yunochi/fpga-sigma-delta-dac/pcb/sigma-delta-dac-pcb/sigma-delta-dac-pcb.kicad_pcb

## KiCad design pcb/sigma-delta-dac-pcb/sigma-delta-dac-pcb.kicad_pcb (2026-08-06)

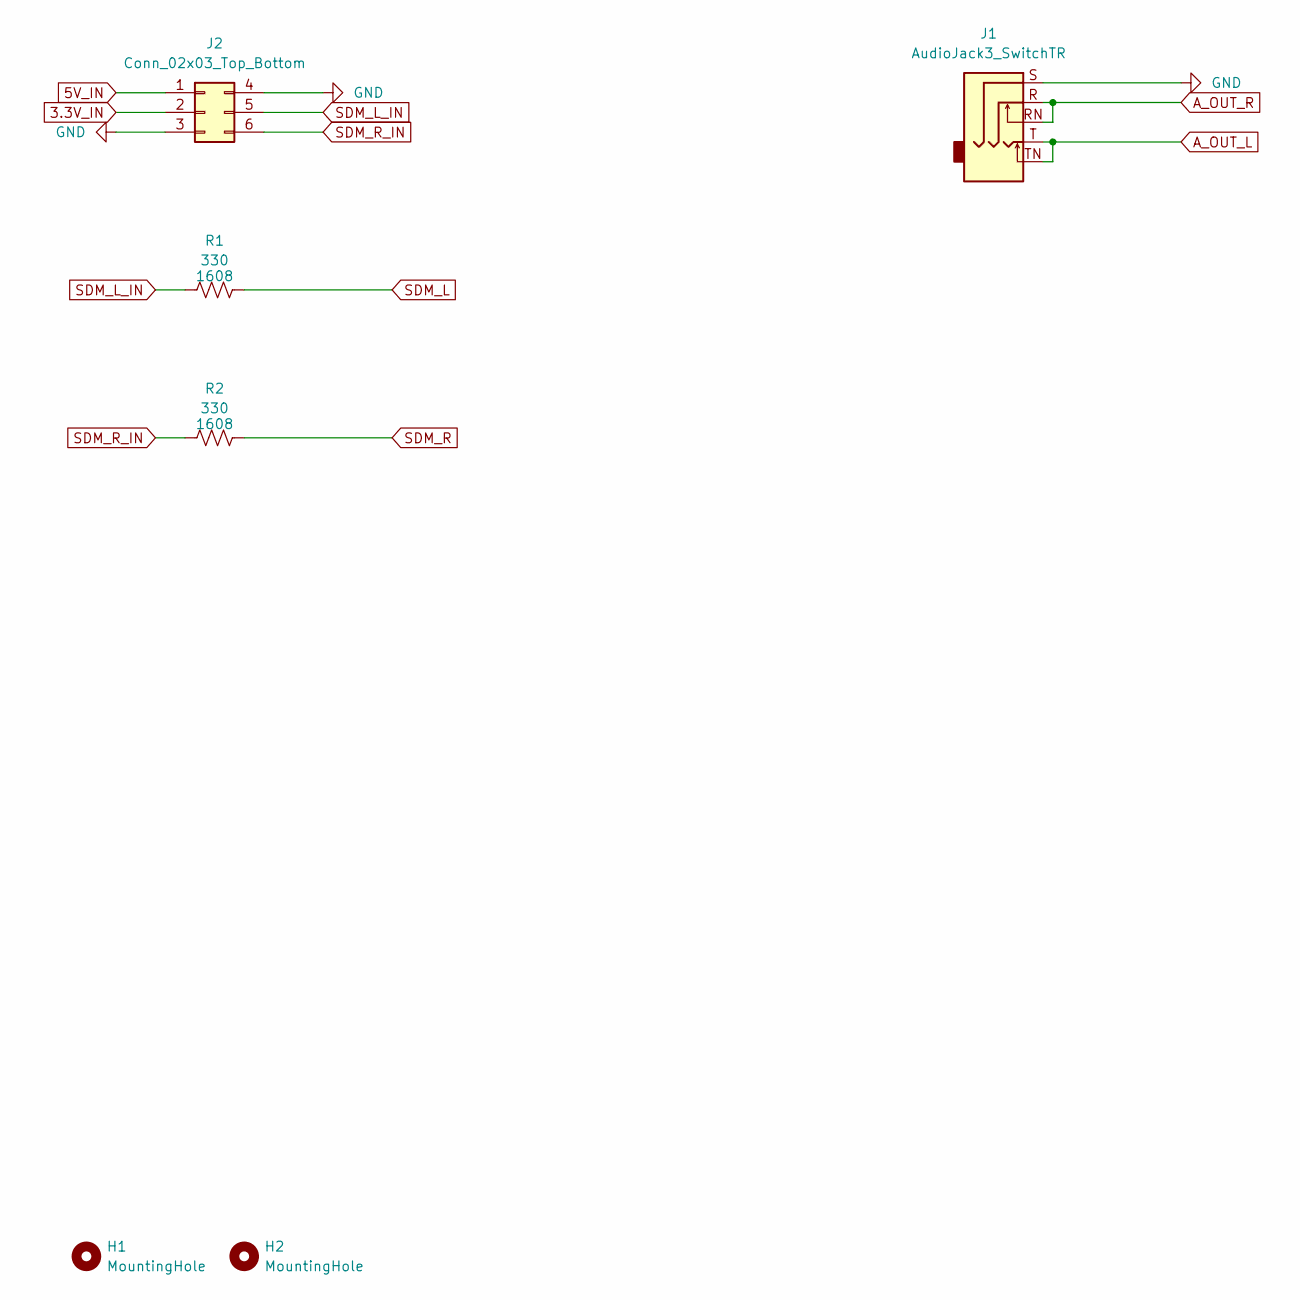
[picture p1: schematic conn.kicad_sch]

Parts:
H1, H2: MountingHole; MountingHole_3.2mm_M3
J1: AudioJack3_SwitchTR; Jack_3.5mm_CUI_SJ1-3525N_Horizontal
J2: Conn_02x03_Top_Bottom; PinSocket_2x03_P2.54mm_Vertical
R1, R2: 330; R_0603_1608Metric

Connections:
3.3V_IN: J2.2
5V_IN: J2.1; also elsewhere on the board
A_OUT_L: J1.T, J1.TN; also elsewhere on the board
A_OUT_R: J1.R, J1.RN; also elsewhere on the board
GND: J1.S, J2.3, J2.4; also elsewhere on the board
SDM_L: R1.2; also elsewhere on the board
SDM_L_IN: J2.5, R1.1
SDM_R: R2.2; also elsewhere on the board
SDM_R_IN: J2.6, R2.1

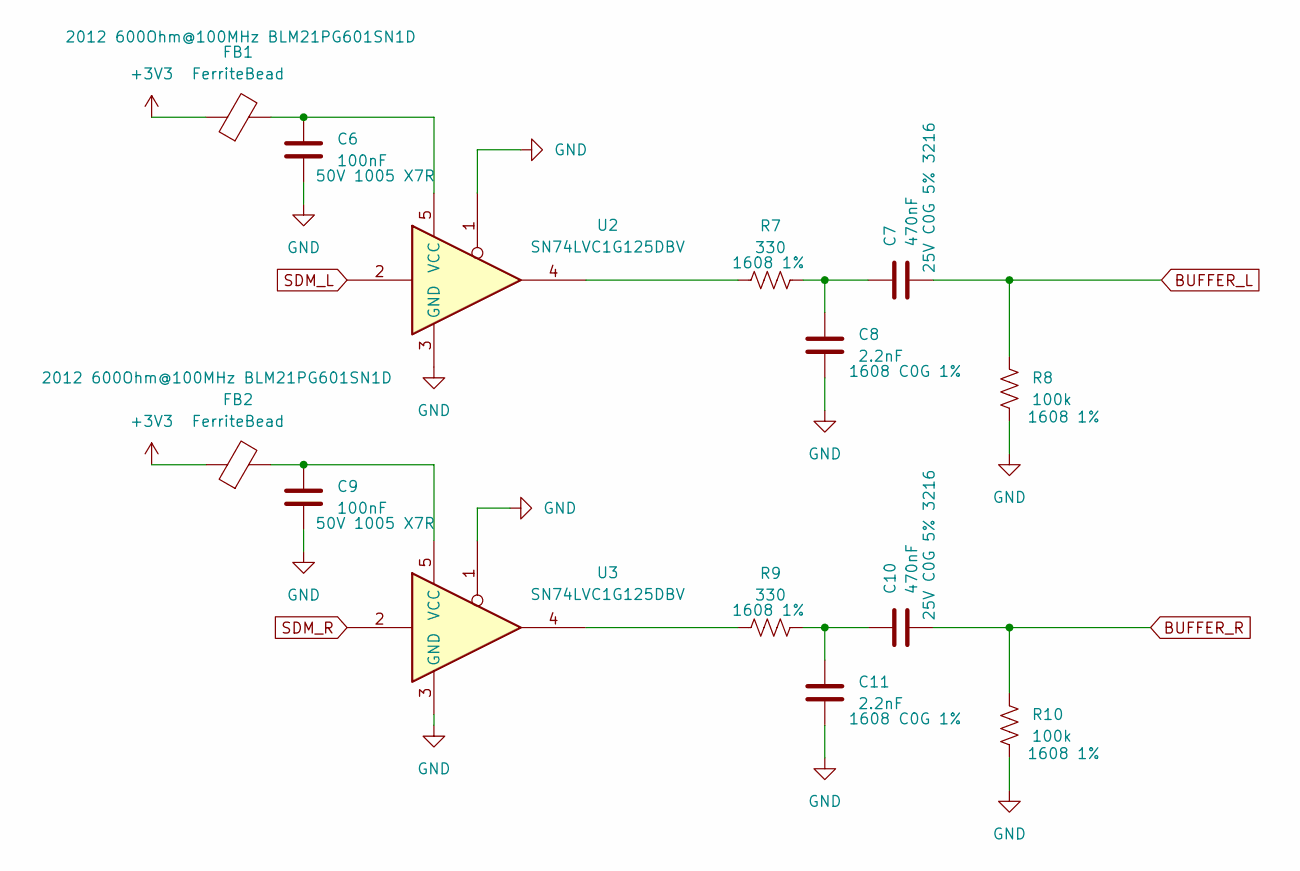
[picture p2: schematic buffer.kicad_sch]

Parts:
C6, C9: 100nF; C_0402_1005Metric
C7, C10: 470nF; C_1206_3216Metric
C8, C11: 2.2nF; C_0603_1608Metric
FB1, FB2: FerriteBead; L_0805_2012Metric
R7, R9: 330; R_0603_1608Metric
R8, R10: 100k; R_0603_1608Metric
U2, U3: SN74LVC1G125DBV; SOT-23-5

Connections:
+3V3: FB1.1, FB2.1; also elsewhere on the board
BUFFER_L: C7.2, R8.1; also elsewhere on the board
BUFFER_R: C10.2, R10.1; also elsewhere on the board
GND: C6.2, C8.2, C9.2, C11.2, R8.2, R10.2, U2.1, U2.3 (GND), U3.1, U3.3 (GND); also elsewhere on the board
unnamed: C7.1, C8.1, R7.2
unnamed: C10.1, C11.1, R9.2
unnamed: R7.1, U2.4
unnamed: R9.1, U3.4
unnamed: C6.1, FB1.2, U2.5 (VCC)
unnamed: C9.1, FB2.2, U3.5 (VCC)
SDM_L: U2.2; also elsewhere on the board
SDM_R: U3.2; also elsewhere on the board

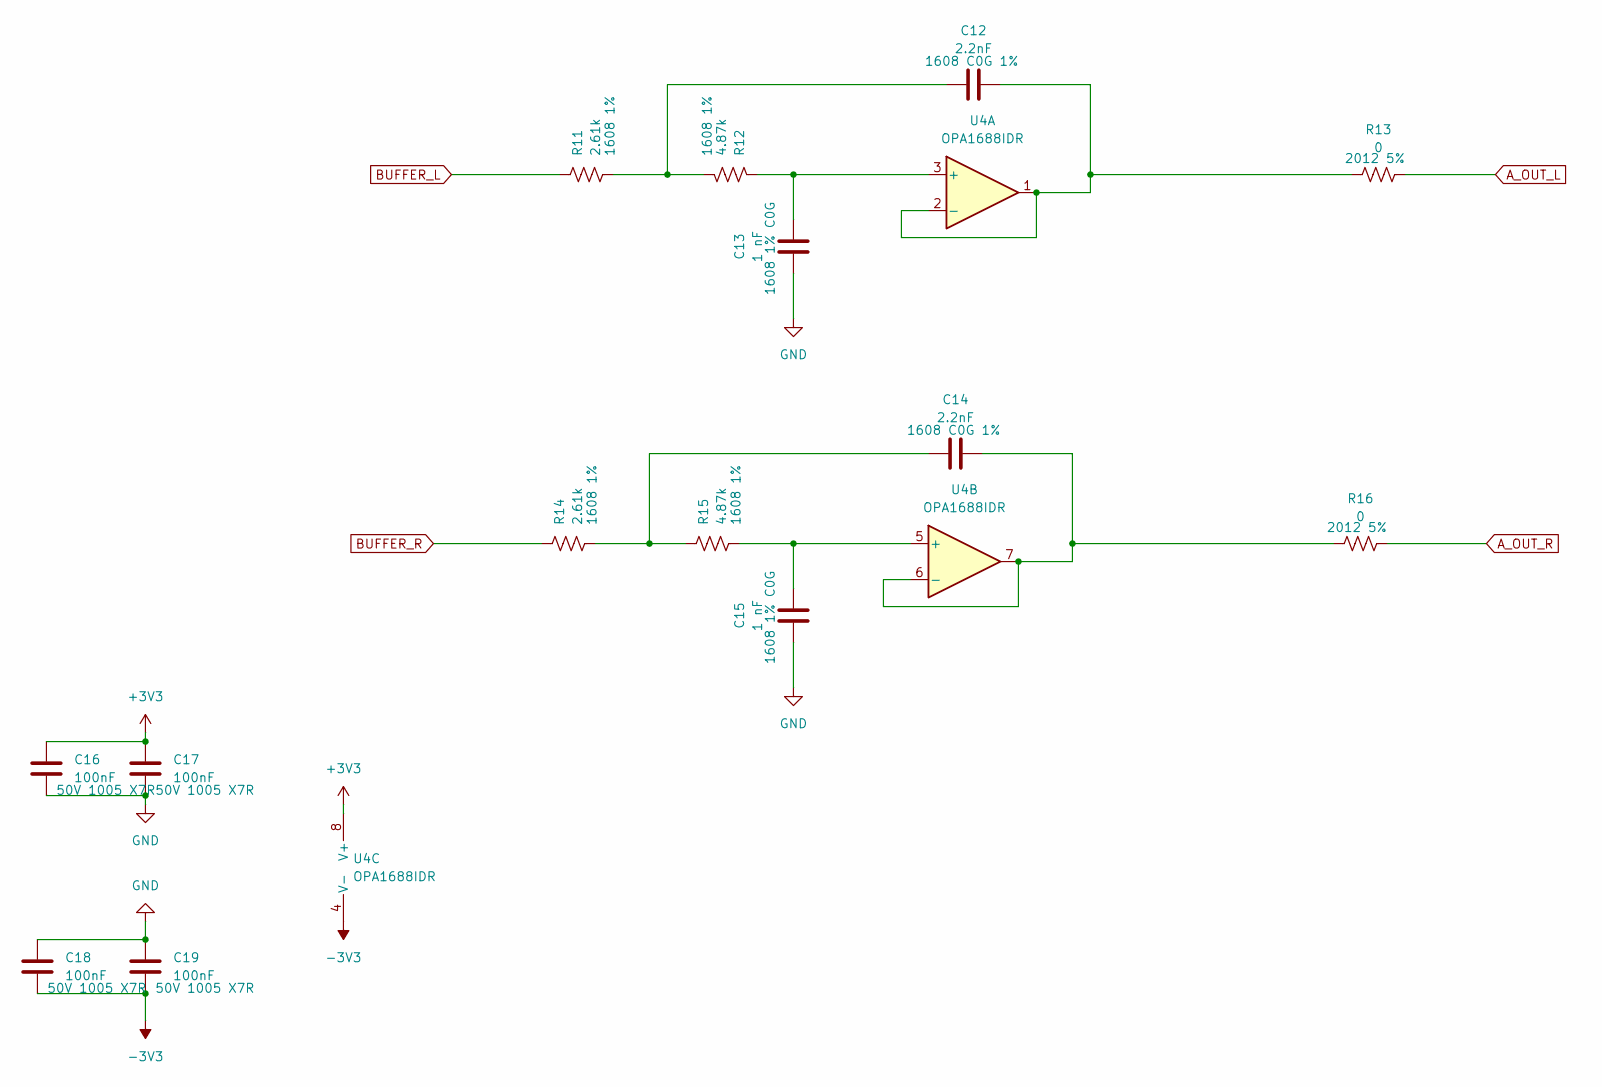
[picture p3: schematic filter.kicad_sch]

Parts:
C12, C14: 2.2nF; C_0603_1608Metric
C13, C15: 1 nF; C_0603_1608Metric
C16, C17, C18, C19: 100nF; C_0402_1005Metric
R11, R14: 2.61k; R_0603_1608Metric
R12, R15: 4.87k; R_0603_1608Metric
R13, R16: 0; R_0805_2012Metric
U4: OPA1688IDR; SOIC-8_3.9x4.9mm_P1.27mm

Connections:
+3V3: C16.1, C17.1, U4.8 (V+); also elsewhere on the board
-3V3: C18.2, C19.2, U4.4 (V-); also elsewhere on the board
A_OUT_L: R13.2; also elsewhere on the board
A_OUT_R: R16.2; also elsewhere on the board
BUFFER_L: R11.1; also elsewhere on the board
BUFFER_R: R14.1; also elsewhere on the board
GND: C13.1, C15.1, C16.2, C17.2, C18.1, C19.1; also elsewhere on the board
unnamed: C12.1, R11.2, R12.2
unnamed: C14.1, R14.2, R15.1
unnamed: C13.2, R12.1, U4.3 (+)
unnamed: C12.2, R13.1, U4.1, U4.2 (-)
unnamed: C15.2, R15.2, U4.5 (+)
unnamed: C14.2, R16.1, U4.6 (-), U4.7

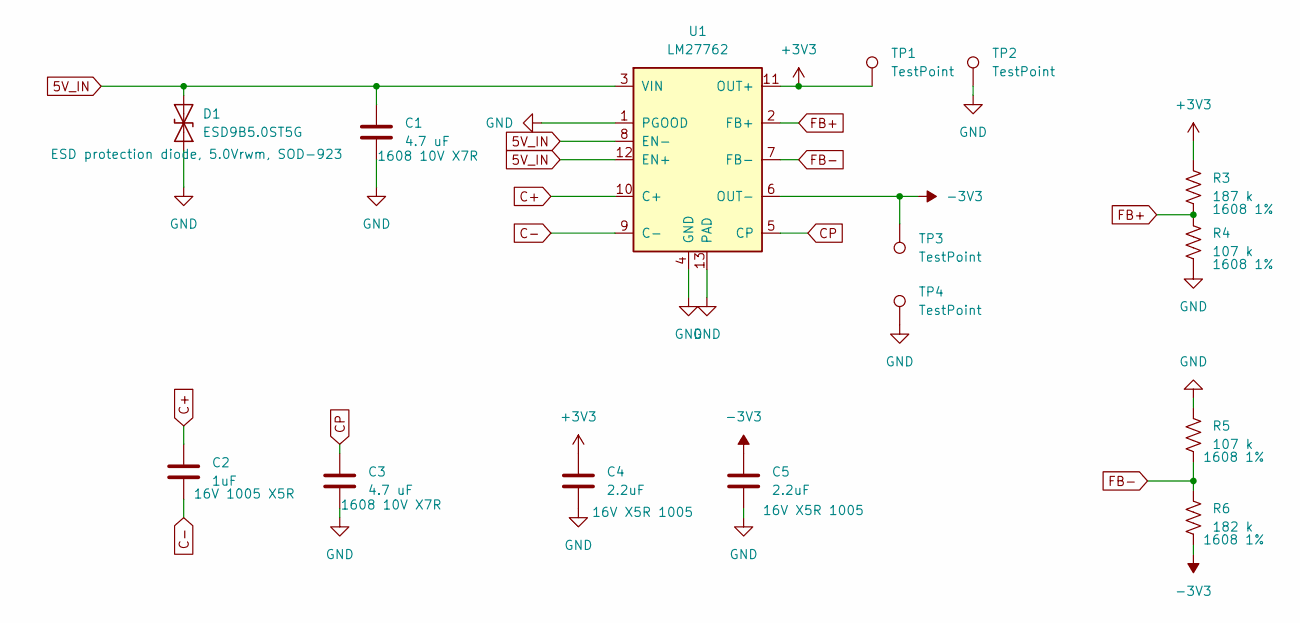
[picture p4: schematic power.kicad_sch]

Parts:
C1, C3: 4.7 uF; C_0603_1608Metric
C2: 1uF; C_0402_1005Metric
C4, C5: 2.2uF; C_0402_1005Metric
D1: ESD9B5.0ST5G; D_SOD-923
R3: 187 k; R_0603_1608Metric
R4, R5: 107 k; R_0603_1608Metric
R6: 182 k; R_0603_1608Metric
TP1, TP2, TP3, TP4: TestPoint; TestPoint_Pad_1.0x1.0mm
U1: LM27762; WSON-12-1EP_3x2mm_P0.5mm_EP1x2.65_ThermalVias

Connections:
5V_IN: C1.1, D1.2 (A2), U1.3 (VIN), U1.8 (EN-), U1.12 (EN+); also elsewhere on the board
+3V3: C4.1, R3.1, TP1.1 (1_1), U1.11 (OUT+); also elsewhere on the board
-3V3: C5.1, R6.2, TP3.1 (1_1), U1.6 (OUT-); also elsewhere on the board
C+: C2.1, U1.10 (C+)
C-: C2.2, U1.9 (C-)
CP: C3.1, U1.5 (CP)
FB+: R3.2, R4.1, U1.2 (FB+)
FB-: R5.2, R6.1, U1.7 (FB-)
GND: C1.2, C3.2, C4.2, C5.2, D1.1 (A1), R4.2, R5.1, TP2.1 (1_1), TP4.1 (1_1), U1.1 (PGOOD), U1.4 (GND), U1.13 (PAD); also elsewhere on the board

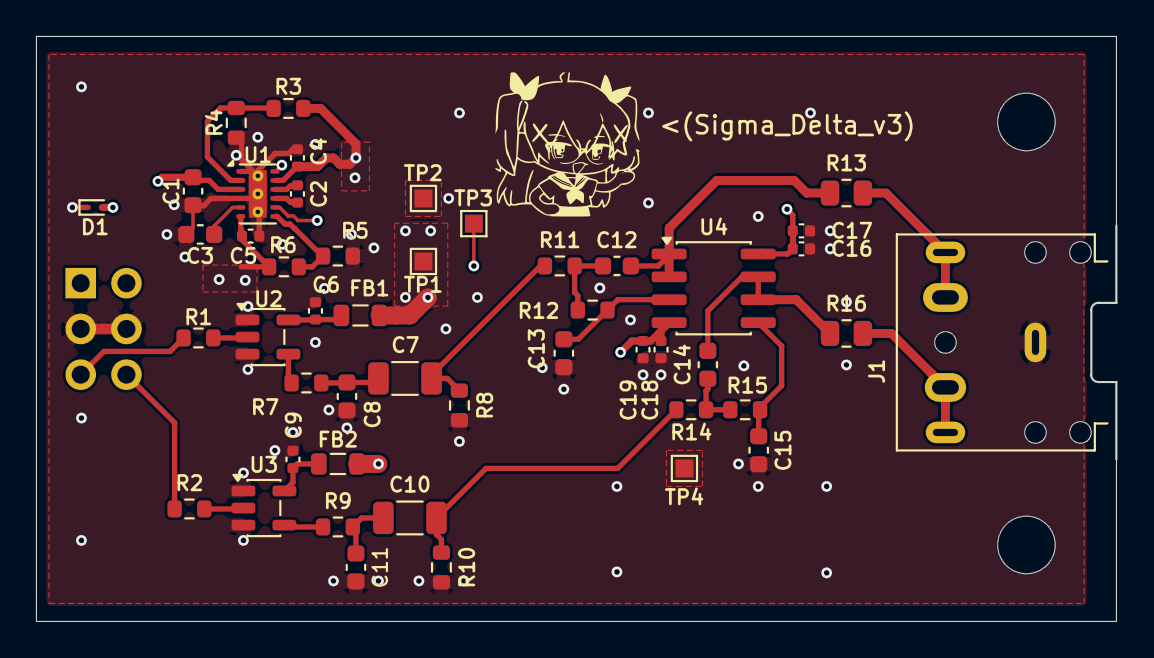
[picture p5: board sigma-delta-dac-pcb.kicad_pcb from above]

Board: 4 copper layers, 60.0 x 32.5 mm, 50 parts (1 on the bottom side), 29 nets.
