yunochi/fpga-sigma-delta-dac/fpga/xilinx/src/xdc/puzhi/new/puzhi.xdc

set_property PACKAGE_PIN W10 [get_ports pdm_out_l]
set_property PACKAGE_PIN AA11 [get_ports pdm_out_r]

set_property IOSTANDARD LVCMOS33 [get_ports pdm_out_*]
set_property DRIVE 16 [get_ports pdm_out_*]
set_property SLEW SLOW [get_ports pdm_out_*]
set_max_delay 30.0 -to [get_ports pdm_out_*]
set_min_delay 0 -to [get_ports pdm_out_*]

set_property IOSTANDARD LVCMOS33 [get_ports s_i2s_*]
set_property PACKAGE_PIN Y12 [get_ports s_i2s_sck]
set_property PACKAGE_PIN AG13 [get_ports s_i2s_ws]
set_property PACKAGE_PIN AA12 [get_ports s_i2s_sd]

set_max_delay 30.0 -from [get_ports s_i2s_sd]
set_min_delay 0 -from [get_ports s_i2s_sd]
set_max_delay 20.0 -to [get_ports s_i2s_sck]
set_min_delay 0 -to [get_ports s_i2s_sck]
set_max_delay 20.0 -to [get_ports s_i2s_ws]
set_min_delay 0 -to [get_ports s_i2s_ws]

set_property IOSTANDARD LVDS [get_ports clk_200M_*]
set_property PACKAGE_PIN L3 [get_ports clk_200M_p]
set_property PACKAGE_PIN L2 [get_ports clk_200M_n]
set_property DIFF_TERM_ADV TERM_100 [get_ports clk_200M_*]
create_clock -period 5.000 -name clk_200M [get_ports clk_200M_p]

set_property PACKAGE_PIN AH6 [get_ports data_act_led]
set_property IOSTANDARD LVCMOS18 [get_ports data_act_led]
set_false_path -to [get_ports data_act_led]

set_property PACKAGE_PIN D2 [get_ports sys_rstn_i]
set_property IOSTANDARD LVCMOS18 [get_ports sys_rstn_i]
set_false_path -from [get_ports sys_rstn_i]

set_property BITSTREAM.GENERAL.COMPRESS TRUE [current_design]
