yunochi/fpga-sigma-delta-dac/fpga/xilinx/src/hdl/top.v

`timescale 1ns / 1ps


module top(
        output pdm_out_l,
        output pdm_out_r,
        input clk_200M_p,
        input clk_200M_n,
        output s_i2s_sck,
        output s_i2s_ws,
        input s_i2s_sd,
        input wire sys_rstn_i,
        output wire data_act_led
    );
    wire diff_buf_out;
    IBUFDS IBUFDS_inst (
               .O(diff_buf_out),
               .I(clk_200M_p),
               .IB(clk_200M_n)
           );
    wire clk_200M;
    BUFG BUFG_inst (
             .O(clk_200M), // 1-bit output: Clock output.
             .I(diff_buf_out)  // 1-bit input: Clock input.
         );

    wire sys_clk; //24.576MHz Clock
    parameter OVERSAMPLE_RATIO = 256;

    wire reset_n;
    wire [31:0]axis_tdata;
    wire axis_tlast;
    reg axis_tready;
    wire axis_tvalid;

    design_1_wrapper design_1_wrapper_inst (
                         .clk_200M(clk_200M),
                         .sys_clk(sys_clk),
                         .sys_rstn_i(sys_rstn_i),
                         .reset_n(reset_n)
                     );
    i2s_rx i2s_rx_inst(
               .clk(sys_clk),
               .rst_n(reset_n),
               .sck(s_i2s_sck),
               .ws(s_i2s_ws),
               .sd(s_i2s_sd),
               .tready(axis_tready),
               .tdata(axis_tdata),
               .data_valid(axis_tvalid),
               .data_act_led(data_act_led),
               .fifo_empty(),
               .fifo_full(),
               .fifo_data_count()
           );
    wire signed [15:0] pdm_val_l;
    wire signed [15:0] pdm_val_r;
    wire signed [15:0] fir_out_l_2x;
    wire signed [15:0] fir_out_l_4x;
    wire signed [15:0] fir_out_r_2x;
    wire signed [15:0] fir_out_r_4x;

    reg [15:0] sample_wait_cnt;
    reg [15:0] pcm_in_l;
    reg [15:0] pcm_in_r;

    always @(posedge sys_clk) begin
        if (!reset_n) begin
            axis_tready <= 0;
            sample_wait_cnt <= 0;
            pcm_in_l <= 0; pcm_in_r <= 0;
        end
        else begin
            if (axis_tvalid && axis_tready) begin
                axis_tready <= 0;
                sample_wait_cnt <= 0;
                pcm_in_l <= axis_tdata[15:0];
                pcm_in_r <= axis_tdata[31:16];
            end
            else begin
                // 카운터가 끝에 도달할 때까지 증가 (데이터가 안 오면 OVERSAMPLE_RATIO-1 에서 유지)
                if (sample_wait_cnt < OVERSAMPLE_RATIO-1) begin
                    sample_wait_cnt <= sample_wait_cnt + 1;
                end
                if (sample_wait_cnt == OVERSAMPLE_RATIO-2) begin
                    // 다음 클럭에 새 데이터 캡쳐하기 위해 미리 tready 를 1로 설정
                    axis_tready <= 1;
                end
            end
        end
    end

    fir_upsampler_2x #(
                         .DATA_WIDTH(16),
                         .OVERSAMPLING_RATIO(OVERSAMPLE_RATIO)
                     ) fir_l_2x (
                         .clk(sys_clk),
                         .rst_n(reset_n),
                         .data_in(pcm_in_l),
                         .interval_cnt(sample_wait_cnt),
                         .data_out(fir_out_l_2x)
                     );
    fir_upsampler_2x #(
                         .DATA_WIDTH(16),
                         .OVERSAMPLING_RATIO(OVERSAMPLE_RATIO / 2)
                     ) fir_l_4x (
                         .clk(sys_clk),
                         .rst_n(reset_n),
                         .data_in(fir_out_l_2x),
                         .interval_cnt(sample_wait_cnt),
                         .data_out(fir_out_l_4x)
                     );
    linear_interpolation #(
                             .DATA_WIDTH(16),
                             .OVERSAMPLING_RATIO(OVERSAMPLE_RATIO / 4)
                         ) interpolation_l (
                             .clk(sys_clk),
                             .rst_n(reset_n),
                             .data_in(fir_out_l_4x),
                             .interval_cnt(sample_wait_cnt),
                             .data_out(pdm_val_l)
                         );

    fir_upsampler_2x #(
                         .DATA_WIDTH(16),
                         .OVERSAMPLING_RATIO(OVERSAMPLE_RATIO)
                     ) fir_r_2x (
                         .clk(sys_clk),
                         .rst_n(reset_n),
                         .data_in(pcm_in_r),
                         .interval_cnt(sample_wait_cnt),
                         .data_out(fir_out_r_2x)
                     );
    fir_upsampler_2x #(
                         .DATA_WIDTH(16),
                         .OVERSAMPLING_RATIO(OVERSAMPLE_RATIO / 2)
                     ) fir_r_4x (
                         .clk(sys_clk),
                         .rst_n(reset_n),
                         .data_in(fir_out_r_2x),
                         .interval_cnt(sample_wait_cnt),
                         .data_out(fir_out_r_4x)
                     );
    linear_interpolation #(
                             .DATA_WIDTH(16),
                             .OVERSAMPLING_RATIO(OVERSAMPLE_RATIO / 4)
                         ) interpolation_r (
                             .clk(sys_clk),
                             .rst_n(reset_n),
                             .data_in(fir_out_r_4x),
                             .interval_cnt(sample_wait_cnt),
                             .data_out(pdm_val_r)
                         );

    sigma_delta_3rd_order sg_inst_l (
                              .clk(sys_clk),
                              .rst_n(reset_n),
                              .din(pdm_val_l),
                              .dout(pdm_out_l)
                          );
    sigma_delta_3rd_order sg_inst_r (
                              .clk(sys_clk),
                              .rst_n(reset_n),
                              .din(pdm_val_r),
                              .dout(pdm_out_r)
                          );

endmodule
