yunochi/fpga-sigma-delta-dac/fpga/common/rtl/fir_upsample.v

module fir_upsampler_2x #(
        parameter integer DATA_WIDTH = 16,
        parameter integer OVERSAMPLING_RATIO = 256
    ) (
        input wire clk,
        input wire rst_n,
        input wire signed [DATA_WIDTH-1:0] data_in,
        input wire [15:0] interval_cnt,
        output reg signed [DATA_WIDTH-1:0] data_out
    );

    wire [15:0] interval_cnt_mod = interval_cnt & (OVERSAMPLING_RATIO - 1);
    // =========================================================================
    // Filter Architecture & Storage
    // =========================================================================
    // 127-tap symmetric Half-Band FIR filter.
    // Since it's a Half-Band filter, every even tap is zero.
    // Thus, we store 64 input samples to compute the symmetric even samples.
    reg signed [DATA_WIDTH-1:0] x_reg [0:63];

    // Shift register for input samples.
    // Triggered at the beginning of a new input sample period (interval_cnt_mod == 0).
    integer i;
    always @(posedge clk or negedge rst_n) begin
        if (!rst_n) begin
            for (i = 0; i < 64; i = i + 1) begin
                x_reg[i] <= {DATA_WIDTH{1'b0}};
            end
        end else if (interval_cnt_mod == 16'd0) begin
            x_reg[0] <= data_in;
            for (i = 1; i < 64; i = i + 1) begin
                x_reg[i] <= x_reg[i-1];
            end
        end
    end

    // 32 non-zero coefficients for the symmetric taps (left/right half).
    // Q15 fixed-point representation.
    function signed [15:0] get_coef(input [4:0] idx);
        begin
            case (idx)
                // Verilog get_coef(idx) values, idx=0 (outermost) -> idx=63 (innermost):
                5'd0:  get_coef = -16'sd26;
                5'd1:  get_coef = 16'sd28;
                5'd2:  get_coef = -16'sd32;
                5'd3:  get_coef = 16'sd36;
                5'd4:  get_coef = -16'sd44;
                5'd5:  get_coef = 16'sd54;
                5'd6:  get_coef = -16'sd66;
                5'd7:  get_coef = 16'sd80;
                5'd8:  get_coef = -16'sd98;
                5'd9:  get_coef = 16'sd118;
                5'd10:  get_coef = -16'sd140;
                5'd11:  get_coef = 16'sd168;
                5'd12:  get_coef = -16'sd200;
                5'd13:  get_coef = 16'sd234;
                5'd14:  get_coef = -16'sd274;
                5'd15:  get_coef = 16'sd320;
                5'd16:  get_coef = -16'sd372;
                5'd17:  get_coef = 16'sd430;
                5'd18:  get_coef = -16'sd496;
                5'd19:  get_coef = 16'sd574;
                5'd20:  get_coef = -16'sd662;
                5'd21:  get_coef = 16'sd766;
                5'd22:  get_coef = -16'sd888;
                5'd23:  get_coef = 16'sd1036;
                5'd24:  get_coef = -16'sd1220;
                5'd25:  get_coef = 16'sd1456;
                5'd26:  get_coef = -16'sd1770;
                5'd27:  get_coef = 16'sd2215;
                5'd28:  get_coef = -16'sd2899;
                5'd29:  get_coef = 16'sd4115;
                5'd30:  get_coef = -16'sd6922;
                5'd31:  get_coef = 16'sd20863;
                default: get_coef = 16'sd0;
            endcase
        end
    endfunction

    // =========================================================================
    // Pipelined Serial MAC (Multiply-Accumulate) Control & Datapath
    // =========================================================================
    // The MAC unit computes the even sample using symmetric pre-addition.
    //
    // Pipeline Timeline:
    // Cycle t   (interval_cnt_mod 0 ~ 31)  : Pre-adder & Coefficient fetch
    // Cycle t+1 (interval_cnt_mod 1 ~ 32)  : Multiplication
    // Cycle t+2 (interval_cnt_mod 2 ~ 33)  : Accumulation (init on cycle 2)
    // Cycle t+3 (interval_cnt_mod 34)      : Saturation and Registering even output

    // Pipeline Stage Enables
    wire preadd_en  = (interval_cnt_mod < 32);
    wire mul_en     = (interval_cnt_mod >= 1 && interval_cnt_mod <= 32);
    wire accum_init = (interval_cnt_mod == 2);
    wire accum_en   = (interval_cnt_mod >= 3 && interval_cnt_mod <= 33);
    wire out_en     = (interval_cnt_mod == 34);

    // Datapath Registers
    reg signed [DATA_WIDTH:0]    pre_add;  // Pre-adder output (17 bits for 16-bit input)
    reg signed [15:0]            coef_reg; // Coefficient register
    reg signed [DATA_WIDTH+16:0] mul_val;  // Multiplier output (33 bits)
    reg signed [DATA_WIDTH+21:0] accum;    // Accumulator (adds 32 products, needs +5 bits headroom)
    reg signed [DATA_WIDTH-1:0]  even_out; // Registered even output sample

    // Cycle t: Pre-adder & Coefficient fetch (1-cycle latency)
    // Pre-adds symmetric input samples: x[idx] + x[63 - idx]
    always @(posedge clk  or negedge rst_n) begin
        if (!rst_n) begin
            pre_add  <= {(DATA_WIDTH+1){1'b0}};
            coef_reg <= 16'sd0;
        end else if (preadd_en) begin
            pre_add  <= $signed(x_reg[interval_cnt_mod[4:0]]) + $signed(x_reg[63 - interval_cnt_mod[4:0]]);
            coef_reg <= get_coef(interval_cnt_mod[4:0]);
        end
    end

    // Cycle t+1: Multiplier (1-cycle latency)
    // Computes pre_add * coef_reg
    always @(posedge clk or negedge rst_n) begin
        if (!rst_n) begin
            mul_val <= {(DATA_WIDTH+17){1'b0}};
        end else if (mul_en) begin
            mul_val <= pre_add * coef_reg;
        end
    end

    // Cycle t+2: Accumulator (1-cycle latency)
    always @(posedge clk or negedge rst_n) begin
        if (!rst_n) begin
            accum <= {(DATA_WIDTH+21){1'b0}};
        end else begin
            if (accum_init) begin
                accum <= mul_val;
            end else if (accum_en) begin
                accum <= accum + mul_val;
            end
        end
    end

    // Cycle t+3: Saturation (1-cycle latency)
    // The coefficients are in Q15 format, so we shift right by 15.
    // The accumulated sum is saturated to prevent overflow before assigning to 16-bit output.
    wire signed [23:0] sum_shifted = accum >>> 15;

    always @(posedge clk or negedge rst_n) begin
        if (!rst_n) begin
            even_out <= {DATA_WIDTH{1'b0}};
        end else if (out_en) begin
            if (sum_shifted > 32767) begin
                even_out <= 32767;
            end else if (sum_shifted < -32768) begin
                even_out <= -32768;
            end else begin
                even_out <= sum_shifted[15:0];
            end
        end
    end

    // =========================================================================
    // Center Tap Delay Pipeline
    // =========================================================================
    // For a half-band filter, the center tap is 0.5. To match the latency of the
    // even sample calculations, the center tap sample (x_reg[31])
    // must be delayed by 35 clock cycles.
    reg signed [DATA_WIDTH-1:0] odd_delay [0:34];
    integer k;

    always @(posedge clk or negedge rst_n) begin
        if (!rst_n) begin
            for (k = 0; k < 35; k = k + 1) begin
                odd_delay[k] <= {DATA_WIDTH{1'b0}};
            end
        end else begin
            odd_delay[0] <= x_reg[31];
            for (k = 1; k < 35; k = k + 1) begin
                odd_delay[k] <= odd_delay[k-1];
            end
        end
    end

    wire signed [DATA_WIDTH-1:0] odd_out = odd_delay[34];

    // =========================================================================
    // Output Multiplexer (Even/Odd Interleaving)
    // =========================================================================
    // The output transitions are synchronized, resulting in a 2x upsampled stream.
    //
    // - For the first half of the input sample period, output the even filter result.
    // - For the second half, output the delayed center-tap sample.
    always @(posedge clk or negedge rst_n) begin
        if (!rst_n) begin
            data_out <= {DATA_WIDTH{1'b0}};
        end else begin
            if (interval_cnt_mod < (OVERSAMPLING_RATIO / 2)) begin
                data_out <= even_out;
            end else begin
                data_out <= odd_out;
            end
        end
    end
endmodule
