yunochi/fpga-sigma-delta-dac/fpga/common/rtl/sigma-delta-3rd-order.v

module sigma_delta_3rd_order #(
        parameter integer WIDTH = 32
    ) (
        input wire clk,
        input wire rst_n,
        input wire signed [15:0] din,
        output reg dout
    );

    localparam signed [WIDTH-1:0] POS_FB = 32767 <<< 8;
    localparam signed [WIDTH-1:0] NEG_FB = -32768 <<< 8;

    wire signed [WIDTH-1:0] din_ext = $signed(din) <<< 8;
    wire signed [WIDTH-1:0] fb;
    wire signed [WIDTH-1:0] error;

    reg signed [WIDTH-1:0] integrator1;
    reg signed [WIDTH-1:0] integrator2;
    reg signed [WIDTH-1:0] integrator3;

    // Input scaling (approx 0.8125)
    wire signed [WIDTH-1:0] reduced_din = (din_ext * 26) >>> 5;

    assign fb = (dout == 1'b1) ? POS_FB : NEG_FB;
    assign error = reduced_din - fb;

    // CIFF Feed-forward Summation
    // Using a wider bit-width to prevent overflow during addition
    wire signed [WIDTH+3:0] sum = integrator1 + (integrator2 >>> 2) + (integrator3 >>> 4) + (integrator3 >>> 6);

    always @(posedge clk) begin
        if (!rst_n) begin
            integrator1 <= 0;
            integrator2 <= 0;
            integrator3 <= 0;
            dout       <= 1'b0;
        end
        else begin
            integrator1 <= integrator1 + error;
            integrator2 <= integrator2 + (integrator1 >>> 1);
            integrator3 <= integrator3 + (integrator2 >>> 2);

            dout <= (sum >= 0) ? 1'b1 : 1'b0;
        end
    end
endmodule
