yunochi/fpga-sigma-delta-dac/(commit log)

2026-06-12 pcb 추가
    [sigma-delta-dac-pcb.kicad_pcb, sigma-delta-dac-pcb.kicad_sch]
2026-06-13 ethernet patch 수정
2026-06-15 하프 밴드 FIR필터 추가
2026-06-15 코드 정리
2026-06-16 OPAMP 출력단 저항 수정
    [sigma-delta-dac-pcb.kicad_sch]
2026-06-16 회로도 수정: 50옴 롤백, OPAMP전원 캡 증가
    [sigma-delta-dac-pcb.kicad_sch]
2026-06-17 FPGA 로직 96kHz 입력 + 선형보간으로 변경
2026-06-18 시뮬레이션 수정
    [sigma-delta-dac-pcb.kicad_pcb, sigma-delta-dac-pcb.kicad_sch, sim.kicad_sch]
2026-06-22 v2 회로 - wip
    [conn.kicad_sch, filter.kicad_sch, power.kicad_sch, sigma-delta-dac-pcb.kicad_pcb, sigma-delta-dac-pcb.kicad_sch, sim.kicad_sch]
2026-06-22 Via 추가
    [sigma-delta-dac-pcb.kicad_pcb]
2026-06-23 로직 클럭을 온보드 200MHz 클럭 쓰도록 변경
2026-06-24 V2 보드 완성
    [conn.kicad_sch, filter.kicad_sch, power.kicad_sch, sigma-delta-dac-pcb.kicad_pcb, sim.kicad_sch]
2026-06-30 63탭 FIR필터로 변경
2026-06-30 입력 샘플레이트 48kHz, FIR 필터 사용
2026-06-30 파이프라이닝 적용. 곱셈기 감소
2026-06-30 tb 코드 분리
2026-06-30 FPGA 코드 리팩토링.
    - 모듈별 파일 분리
    - pcm_in_l, pcm_in_r 레지스터 추가
2026-07-01 pico 세팅 추가
2026-07-01 i2s_rx.v 생성
2026-07-01 USB-i2s 코드 수정
2026-07-02 i2s_rx 업데이트
2026-07-02 gitignore 추가
2026-07-02 fifo 생성 디렉터리 변경
2026-07-02 fifo 세팅 수정
2026-07-03 fw 업데이트, 패치파일 추가
2026-07-03 Debug LED 추가
2026-07-03 feedback 패치된 버전으로 교체
2026-07-03 debug 수정
2026-07-04 FIR 업샘플 필터 127탭으로 상향
2026-07-04 96kHz 로 샘플레이트 변경
2026-07-04 주석 수정
2026-07-05 USB에서 오디오 안 들어올때 i2s 정지
2026-07-05 i2s 수신 FIFO 사이즈 증가 (42.6ms)
2026-07-05 fpga: i2s 수신모듈 개선
    - fw: i2s 전송이 좌우 반전된 문제 수정
    [i2s_rx.v, main.cpp]
2026-07-05 타이밍 제약 업데이트
2026-07-06 fpga 코드 리팩토링
2026-07-06 FPGA 코드 리팩토링...
2026-07-06 테스트벤치 리펙토링, verilator 벤치 추가 (속도 이슈)
2026-07-06 테스트벤치 코드 수정
2026-07-06 USB-> i2s 소프트웨어 PLL 코드 수정
    [main.cpp]
2026-07-07 calc fir 수정
2026-07-07 업샘플링에 사용하는 카운터를 잘못 쓴거 수정
    [fir_upsample.v, top.v]
2026-07-07 Refactor: sample interval counter 는 모듈 안에서 알아서 계산
2026-07-07 더 이상 사용하지 않는 PS DDR, 이더넷 펌웨어 삭제
2026-07-07 FPGA가 FIFO를 반 채우고 재생을 시작하도록
2026-07-10 i2s 타이밍제약 수정
2026-07-14 tang-nano-20k target 추가
2026-07-14 xilinx 4cg 소스 디렉터리 이동
2026-07-14 사용되지 않는 myir xdc 삭제
2026-07-14 tang nano 20k의 rPLL 사용, 리셋 동기화
    - rPLL을 input / output 24.576MHz 로 설정해서 글로벌 클럭으로 사용
    - rPLL의 lock 신호를 reset 으로 사용
    - 리셋 동기화 회로 추가
    [gowin_rpll.v, i2s_rx.v, reset_sync.v, top.v]
2026-07-16 i2s clock master로 동작하도록 변경
2026-07-16 Tang nano 20k SDM 드라이브 16mA
2026-07-16 RP2040 fw: I2S슬레이브로 동작하도록 변경
2026-07-17 tang-nano-20k: I2S FIFO축소, fifo LED삭제, fwft fifo 모듈에 reset추가
    [fwft_fifo.v, i2s_rx.v, top.v]
2026-07-17 FIR업샘플 모듈 비동기 Reset쓰도록
    - Tang nano 20K에서 LUT사용량을 줄이기 위함
    [fir_upsample.v]
2026-07-17 tang-nano-20k도 FIR필터 두개씩 쓰도록
2026-07-17 4cg 보드도 i2s 클럭 마스터로 동작
2026-07-27 V3 보드 WIP
    [buffer.kicad_sch, conn.kicad_sch, filter.kicad_sch, sigma-delta-dac-pcb.kicad_sch, sim.kicad_sch]
2026-07-27 캐패시터 사이즈 변경
    [filter.kicad_sch, power.kicad_sch]
2026-07-28 아트웍 wip
    [filter.kicad_sch, sigma-delta-dac-pcb.kicad_pcb]
2026-07-28 아트웍 완성 (아마도)
    [sigma-delta-dac-pcb.kicad_pcb]
2026-07-29 레이아웃 최적화, opamp 캐패시터 추가
    [buffer.kicad_sch, filter.kicad_sch, power.kicad_sch, sigma-delta-dac-pcb.kicad_pcb]
2026-07-29 via size 수정
    [sigma-delta-dac-pcb.kicad_pcb]
2026-07-29 feat: 실크스크린에 로고 & 버전명 추가
    [sigma-delta-dac-pcb.kicad_pcb]
2026-07-29 logo를 lib로 추가
    [sigma-delta-dac-pcb.kicad_pcb]
2026-08-06 FIX: fwft_fifo 의 동시 read/write때 발생할 수 있는 문제 수정
    [fwft_fifo.v]
2026-08-06 fwft fifo tb 수정
    [fifo_tb.v]
2026-08-06 코드 클린업
2026-08-06 xilinx 와 gowin 프로젝트가 공용 소스는 같이 쓰도록
2026-08-06 PS 리셋 대신 PL리셋 사용
2026-08-07 rp2040 fw 클린업
2026-08-07 xilinx FPGA 제약 수정
    [puzhi.xdc]
2026-08-10 BOM 정리
    [conn.kicad_sch, power.kicad_sch]
